Dulina10/5FTC2140_Connected_Systems_and_IoT/Docs/IOT - CW 03 - 23115093.pdf

School of Physics, Engineering and Computer Science University of Hertfordshire BEng (Hons) Electrical and Electronic Engineering

5FTC2140
Connected Systems and IoT

CW 03

## Individual Reflection – Smart Agriculture IoT System

UH ID | : 23115093
Batch | : Batch 08
Date of Submission : 03/16/2026

School of Physics, Engineering and Computer Science

2 | P a g e

Table of Contents

### 1. Introduction

This project focused on developing a Smart Agriculture IoT system that integrates multiple communication technologies and embedded systems. The goal of the system was to monitor environmental conditions and soil moisture while also controlling irrigation using a distributed IoT architecture. The system consists of two sensor nodes and one central gateway. Node 1 measures environmental parameters such as temperature, humidity, and light intensity, while Node 2 monitors soil moisture and water flow and controls the irrigation pump. All data from the nodes are transmitted to the gateway using LoRa communication and then sent to a cloud dashboard for remote monitoring. In this project I mainly worked on the Gateway system and the Dashboard development. My responsibility was to integrate the LoRa communication with the ESP32 gateway, send the data to the Firebase cloud database, and create the web dashboard for real-time monitoring. I also contributed to system integration and debugging when communication problems occurred.

### 2. Technical Contribution

My main technical contribution in this project was the design and implementation of the Gateway – Central Communication and Processing Unit and the Dashboard system for remote monitoring and control.
The gateway was developed using an ESP32 microcontroller, which acts as the central communication hub of the system. I connected the LoRa module to ESP32 using SPI communication and connected the OLED display using the I2C interface. The gateway program was designed to continuously listen to LoRa packets transmitted from Node 1 and Node 2. Each packet contains sensor data along with a Node ID so that the gateway can identify the source of the data.
When the gateway receives a packet, it decodes the data and displays the values on the OLED screen in real time. This allowed us to visually confirm that the gateway was receiving correct data from the nodes during testing.
Another important part of my work was implementing Wi-Fi communication and cloud integration. The ESP32 gateway connects to Wi-Fi and uploads sensor data to the Firebase Realtime Database. The data is structured in JSON format so that parameters such as temperature, humidity, soil moisture, light intensity, flow rate, and pump status can be stored and accessed easily.
I also designed the web dashboard interface using HTML, CSS, and JavaScript in Visual Studio Code. The dashboard connects to Firebase using its JavaScript API and automatically updates the sensor values when the database changes. This allows users to monitor the system remotely in real time.
In addition to monitoring, I implemented a manual pump control feature on the dashboard. The user can press a button on the dashboard to send a command to Firebase. The gateway reads this command and forwards it to Node 2 through LoRa communication so that the irrigation pump can be controlled remotely.
I also participated in system integration and debugging, making sure that the gateway correctly communicates with both sensor nodes and the cloud database.

### 3. Learning and Challenges

This project helped me learn many important concepts related to IoT system integration, embedded programming, and wireless communication technologies.
One of the most important things I learned was how different communication protocols work together in a single IoT system. In this project we used LoRa for long-range communication between nodes and the gateway, and Wi-Fi for sending data to the cloud platform. Understanding how these layers interact helped me understand real-world IoT architecture.
I also learned how to work with cloud databases such as Firebase. Before this project I had limited experience with cloud-based IoT platforms. Through this project I learned how to send data from a microcontroller to cloud and how to retrieve that data using a web dashboard.
During the project we faced several technical challenges. One major challenge occurred during system integration when the pump motor in Node 2 caused voltage drops and electrical noise. This sometimes caused the LoRa communication to fail or the microcontroller to restart. After investigating the problem, we realized that the motor power supply needed to be separated from the control circuit. After applying this change the communication became stable.
Another challenge occurred with the manual pump control from the dashboard. The dashboard button successfully updated the command in Firebase, and the gateway also received the command correctly. However, the command was not executed at Node 2, so the pump could not be controlled manually through the dashboard. Although the automatic irrigation logic worked correctly, the manual control feature was not fully successful.
Even though this feature was not fully completed, the experience helped me understand how difficult bidirectional communication and command synchronization can be in IoT systems.

### 4. Sustainability and Ethics

Sustainability was an important consideration during the design of this IoT system. The main purpose of the system is to improve water management in agriculture by monitoring soil moisture levels and activating irrigation only when necessary. This helps reduce water waste and ensures efficient irrigation.
The use of LoRa communication also helps reduce power consumption compared to other wireless technologies. This is important for sensor nodes that operate on battery power in remote agricultural environments.
From an ethical perspective, IoT systems must ensure that data is handled responsibly and that system controls are secure. In this project the irrigation control commands are validated through the gateway before being executed. This helps prevent unintended or unauthorized pump activation.
Overall, the system demonstrates how IoT technology can support sustainable farming practices and responsible use of resources.

### 5. Future Improvements

Although the system works successfully, several improvements can be made in the future.
One important improvement would be implementing power management techniques such as deep sleep mode for the sensor nodes. This would reduce energy consumption and extend battery life for long-term deployment.
Another improvement would be to improve the manual pump control communication between the dashboard, gateway, and Node 2. More reliable command synchronization and error handling should be implemented so that the system can fully support remote irrigation control.
The dashboard could also be improved by adding historical data visualization and analytics, allowing users to analyze environmental trends over time.
In the future the system could also integrate AI-based decision making, where irrigation schedules are automatically determined based on sensor data.
These improvements would make the system more scalable and practical for real-world agricultural applications.
